dmorenodev/CubeLed/documentation/original_schematic_a_small.jpg

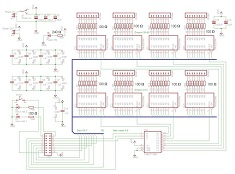
documentation/original_schematic_a_small.jpg
