dmorenodev/CubeLed/documentation/8x8x8_schematic_small.jpg

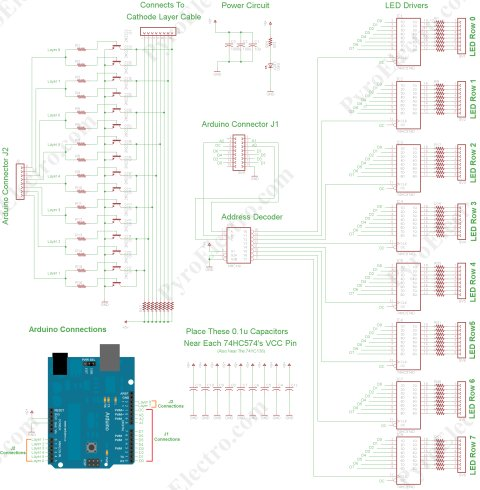
documentation/8x8x8_schematic_small.jpg
