dmorenodev/CubeLed/README.md

CubeLed
=======
Proyecto final de Desarrollo de Aplicaciones Multiplataforma. 

El proyecto consiste en un cubo de Led de matriz 8*8 sincronizado con el ordenador a traves de un placa de arduino modelo one.

El lenguaje utilizado es C# para tener una interfaz gráfica de la forma mas sencilla. El proyecto tambien cuenta con páginas web (Aquí ira el link heroku) en Ruby on Rails.

Para desarrollar la placa base, que contiene todos los componentes, se utilizó la apliccion Kitca
d

El link de ejemplo del proyecto referencia: 
http://www.pyroelectro.com/projects/8x8x8_led_cube/

Emails de los componentes del proyecto:

Pablo Martin Nájera: (pablo.martin.najera@gmail.com) 
David Moreno Moreno: (dmorenodev@gmail.com)
Ramon Carmona Quintero: (ramoncqq@gmail.com)
Denis Martín: (deniml1994@gmail.com)
Borja Moreno: (borjamoreno23@gmail.com)
