dmorenodev/CubeLed/documentation/original_schematic_b_small.jpg

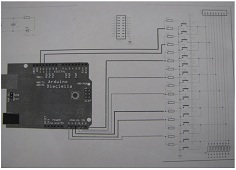
documentation/original_schematic_b_small.jpg
